enriquewph/Tablero-de-Crossfit/573515-030219 - copia.jpg

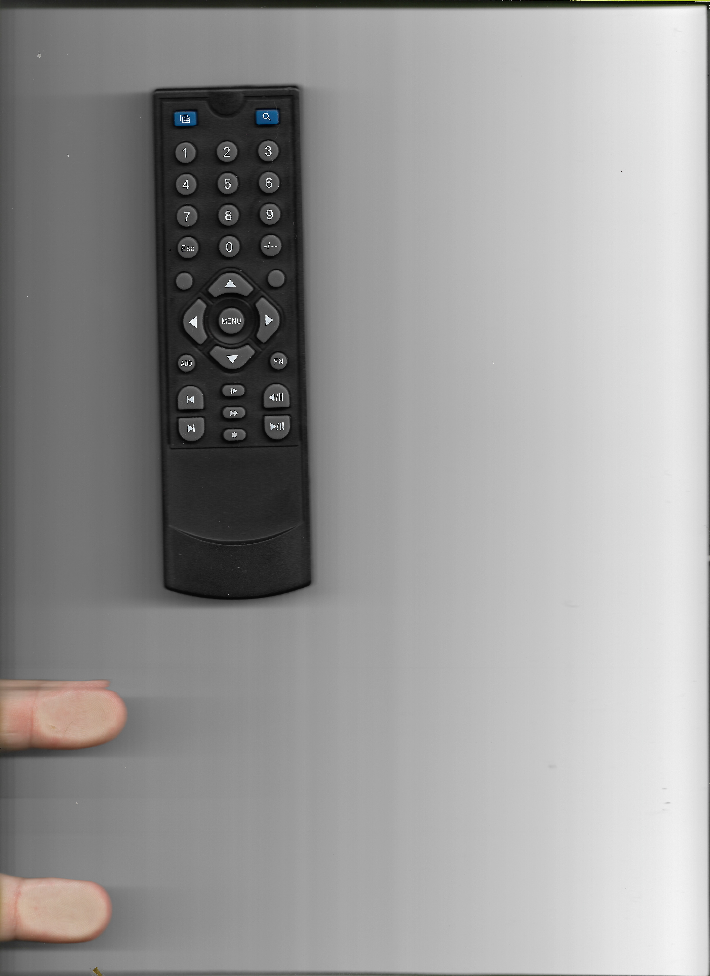
573515-030219 - copia.jpg
