enriquewph/Tablero-de-Crossfit/1.pdf

Componente | Cantidad | Precio | Subtotal
CABLE X METRO 1mm2 NEGRO | 5 | 3,00 $ | 15,00 $
CABLE X METRO 1mm2 ROJO | 2 | 3,00 $ | 6,00 $
CAPACITOR CERÁMICO 100nF | 8 | 2,00 $ | 16,00 $
CAPACITOR CERÁMICO 22pF | 2 | 2,00 $ | 4,00 $
CAPACITOR ELECTROLÍTICO 100uF 16v | 2 | 3,00 $ | 6,00 $
CAPACITOR ELECTROLÍTICO 10uF 16v | 1 | 3,00 $ | 3,00 $
CIRC. INTEGRADO 74HC595 | 6 | 15,00 $ | 90,00 $
CIRC. INTEGRADO ATMEGA328P-PU | 1 | 100,00 $ | 100,00 $
CIRC. INTEGRADO REG. LM7805 | 1 | 10,00 $ | 10,00 $
CONECTOR POLARIZADO 2.54mm 2 PINES Hembra p/Cable | 2 | 2,00 $ | 4,00 $
CONECTOR POLARIZADO 2.54mm 2 PINES Macho p/Placa | 2 | 2,00 $ | 4,00 $
CONECTOR POLARIZADO 2.54mm 3 PINES Hembra p/Cable | 1 | 3,00 $ | 3,00 $
CONECTOR POLARIZADO 2.54mm 3 PINES Macho p/Placa | 1 | 3,00 $ | 3,00 $
CONECTOR POLARIZADO 2.54mm 4 PINES Hembra p/Cable | 3 | 4,00 $ | 12,00 $
CONECTOR POLARIZADO 2.54mm 4 PINES Macho p/Placa | 3 | 4,00 $ | 12,00 $
CONECTOR POLARIZADO 2.54mm 5 PINES Hembra p/Cable | 2 | 4,00 $ | 8,00 $
CONECTOR POLARIZADO 2.54mm 5 PINES Macho p/Placa | 2 | 4,00 $ | 8,00 $
FUENTE CONMUTADA 12V 3A | 1 | 285,00 $ | 285,00 $
LED ROJO 5MM | 596 | 1,30 $ | 773,61 $
OSCILADOR CRISTAL 16MHz | 1 | 3,00 $ | 3,00 $
PINES HEMBRA 2.54MM (TIRA 40) | 2 | 15,00 $ | 30,00 $
PINES MACHO 2.54MM (TIRA 40) | 2 | 10,00 $ | 20,00 $
PINES P/CONECTORES POLARIZADOS (TIRAS DE 50) | 100 | 1,00 $ | 100,00 $
PLACA VIRGEN SIMPLE FAZ 25x25cm | 3 | 40,00 $ | 120,00 $
PLUG DC HEMBRA 2.1mm PARA PANEL | 1 | 10,00 $ | 10,00 $
RESISTENCIA 100 Ohm | 42 | 1,00 $ | 42,00 $
RESISTENCIA 10K Ohm | 44 | 1,00 $ | 44,00 $
RESISTENCIA 200 Ohm | 84 | 2,00 $ | 168,00 $
RESISTENCIA 470 Ohm | 1 | 1,00 $ | 1,00 $
TRANSISTOR BC547 TO92 | 43 | 6,00 $ | 258,00 $
TRANSISTOR TIP120 TO220 | 1 | 10,00 $ | 10,00 $
ZÓCALO DIP16 | 6 | 4,00 $ | 24,00 $
ZÓCALO DIP28 | 1 | 9,00 $ | 9,00 $
CONTROL REMOTO IR | 1 | 40,00 $ | 40,00 $
BATERIA CR20321 | 1 | 40,00 $ | 40,00 $
RECEPTOR IR STOP21332 | 1 | 40,00 $ | 40,00 $
SENSOR TEMP Y HUMEDAD DHT11 | 1 | 50,00 $ | 50,00 $
RESISTENCIA SMD 10K | 1 | 0,25 $ | 0,25 $
PLACA DRIVER 74HC595 | 6 | 30,00 $ | 180,00 $
SUBTOTAL: | 2.551,858 $

# COMPONENTES ELECTRÓNICOS
