enriquewph/Tablero-de-Crossfit/2.pdf

ITEM | CANTIDAD | PRECIO | SUBTOTAL
Separador 5mm | 8 | $ | 2,00 $ | 16,00
Separador 9mm | 52 | $ | 3,00 $ | 156,00
Tornillo M3x10 ALLEN C. CILINDRICA | 4 | $ | 2,38 $ | 9,52
Tornillo M3x10 ALLEN C. FRESADA | 76 | $ | 3,56 $ | 270,56
Tornillo M3x20 ALLEN C. FRESADA | 60 | $ | 3,37 $ | 202,20
Tuerca M3 | 68 | $ | 0,56 $ | 38,08
SUBTOTAL | 692,36

# BULONERÍA
