enriquewph/Tablero-de-Crossfit/573515-030219.jpg

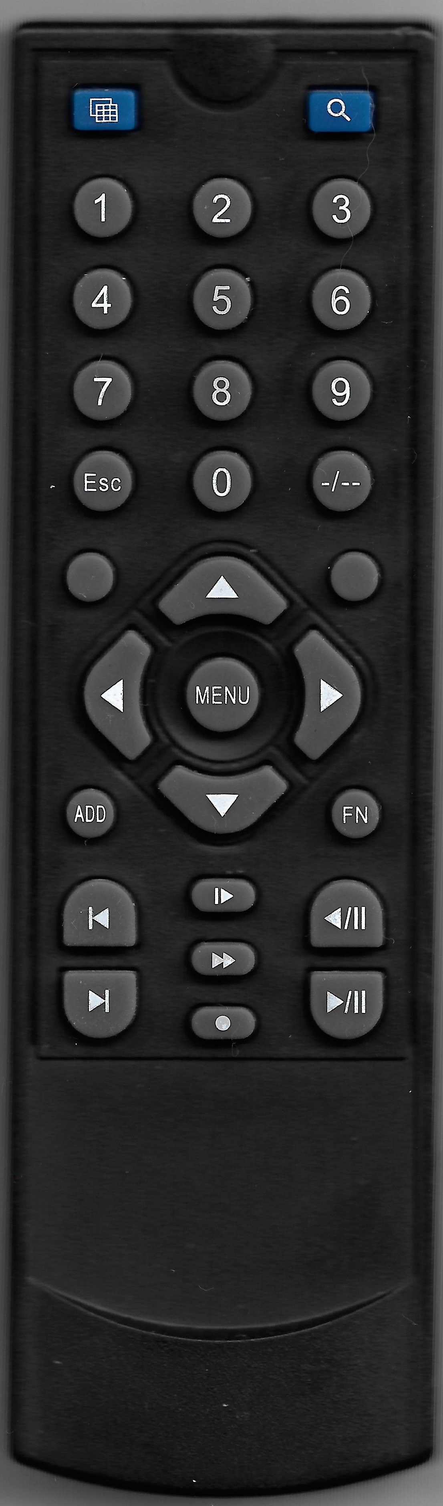
573515-030219.jpg
