enriquewph/Tablero-de-Crossfit/Cotizacion Electrocomponentes.xlsx

Componente | Cantidad | Precio | Subtotal
CAPACITOR ELECTROLÍTICO 100uF 16v | 2 |  | $0.000
CAPACITOR ELECTROLÍTICO 10uF 16v | 1 |  | $0.000
CONECTOR POLARIZADO 2.54mm 2 PINES Hembra p/Cable | 2 |  | $0.000
CONECTOR POLARIZADO 2.54mm 2 PINES Macho p/Placa | 2 |  | $0.000
CONECTOR POLARIZADO 2.54mm 3 PINES Hembra p/Cable | 2 |  | $0.000
CONECTOR POLARIZADO 2.54mm 3 PINES Macho p/Placa | 2 |  | $0.000
CONECTOR POLARIZADO 2.54mm 4 PINES Hembra p/Cable | 1 |  | $0.000
CONECTOR POLARIZADO 2.54mm 4 PINES Macho p/Placa | 1 |  | $0.000
CONECTOR POLARIZADO 2.54mm 5 PINES Hembra p/Cable | 2 |  | $0.000
CONECTOR POLARIZADO 2.54mm 5 PINES Macho p/Placa | 2 |  | $0.000
PINES HEMBRA 2.54MM (TIRA 40) | 2 |  | $0.000
PINES MACHO 2.54MM (TIRA 40) | 2 |  | $0.000
PINES P/CONECTORES POLARIZADOS (TIRAS DE 50) | 100 |  | $0.000
RESISTENCIA 100 Ohm | 42 |  | $0.000
RESISTENCIA 200 Ohm | 84 |  | $0.000
TRANSISTOR BC547 TO92 | 43 |  | $0.000
TRANSISTOR TIP120 TO220 | 1 |  | $0.000
