enriquewph/Tablero-de-Crossfit/CAD/3D MCAD MODELS/MAINBOARD/Mainboard.STEP

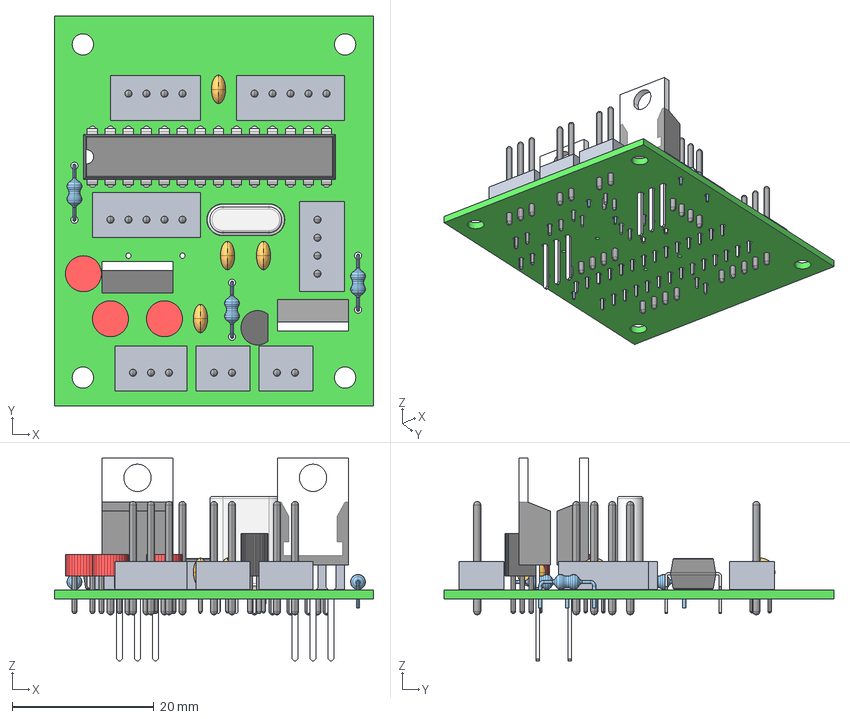
[picture p3: CAD file, 2019-03-29]
CAD/3D MCAD MODELS/MAINBOARD/Mainboard.STEP
45.0 x 55.0 x 28.6 mm
Layer_1
Pin_1 x 15
Pin_2 x 15
Pin_3 x 6
Pin_4 x 4
Pin_5 x 2
=>[0:1:1:3] x 3
=>[0:1:1:4] x 3
=>[0:1:1:5] x 3
