enriquewph/Tablero-de-Crossfit/CAD/Piezas Varias/Ajuste Display.SLDASM

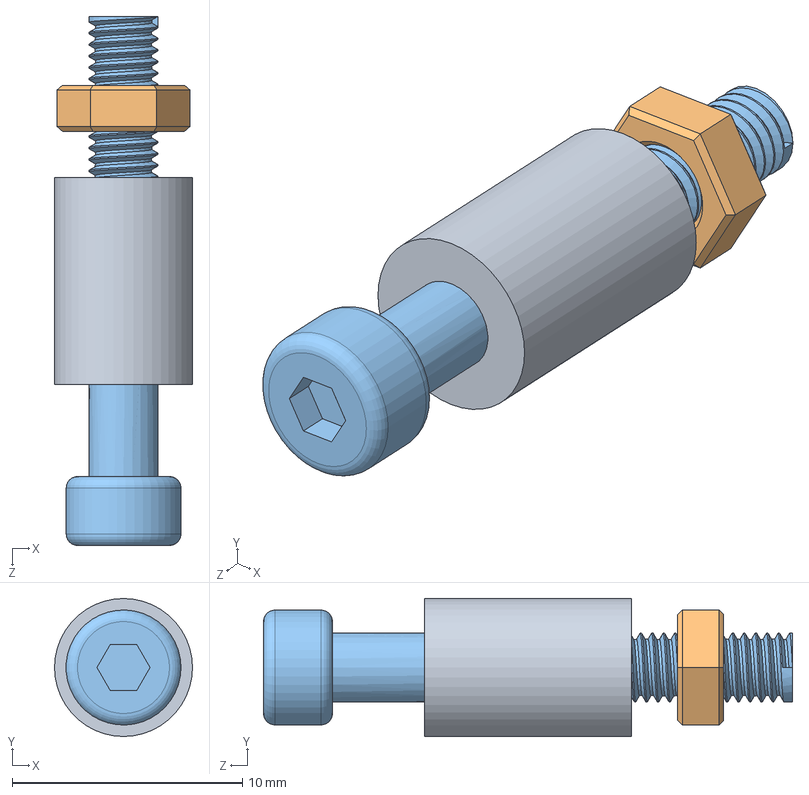
[picture p4: CAD file, 2019-03-29]
CAD/Piezas Varias/Ajuste Display.SLDASM
6.00 x 6.00 x 23.0 mm
Separador
Tuerca M3
Tornillo M3x20_CC
