enriquewph/Tablero-de-Crossfit/CAD/placasviejas/Placa Main.SLDPRT

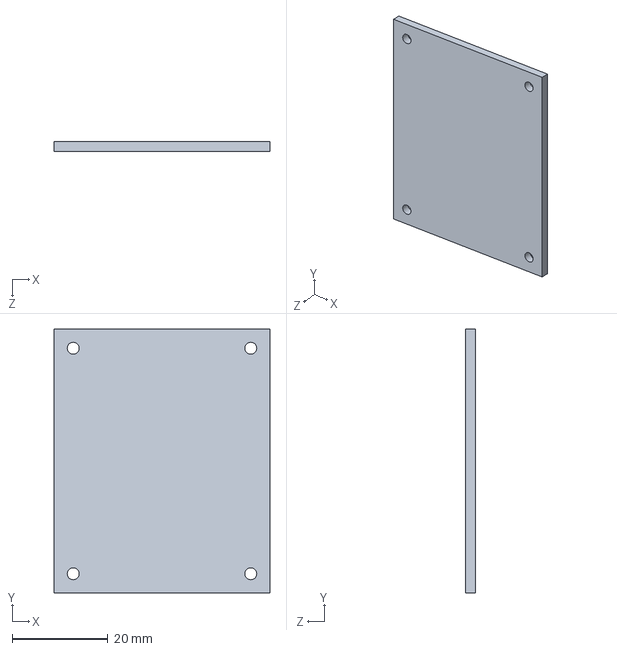
[picture p5: CAD file, 2019-03-29]
CAD/placasviejas/Placa Main.SLDPRT
45.0 x 55.0 x 2.00 mm
