enriquewph/Tablero-de-Crossfit/CAD/placasviejas/PLACAIRDHT.SLDASM

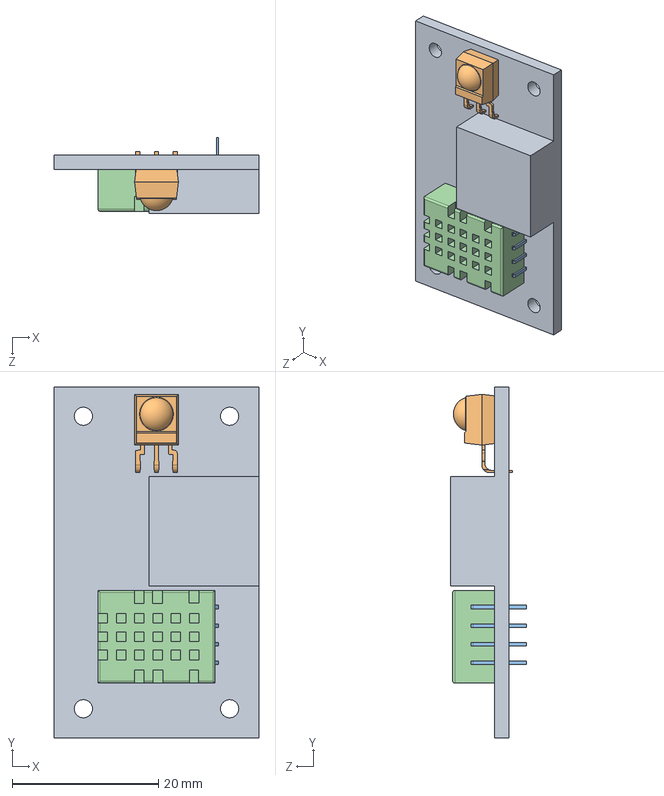
[picture p6: CAD file, 2019-03-29]
CAD/placasviejas/PLACAIRDHT.SLDASM
28.0 x 48.0 x 10.4 mm
PCB
IRREC
