enriquewph/Tablero-de-Crossfit/Proteus/DHT+IR/PLACAFULL.SLDASM

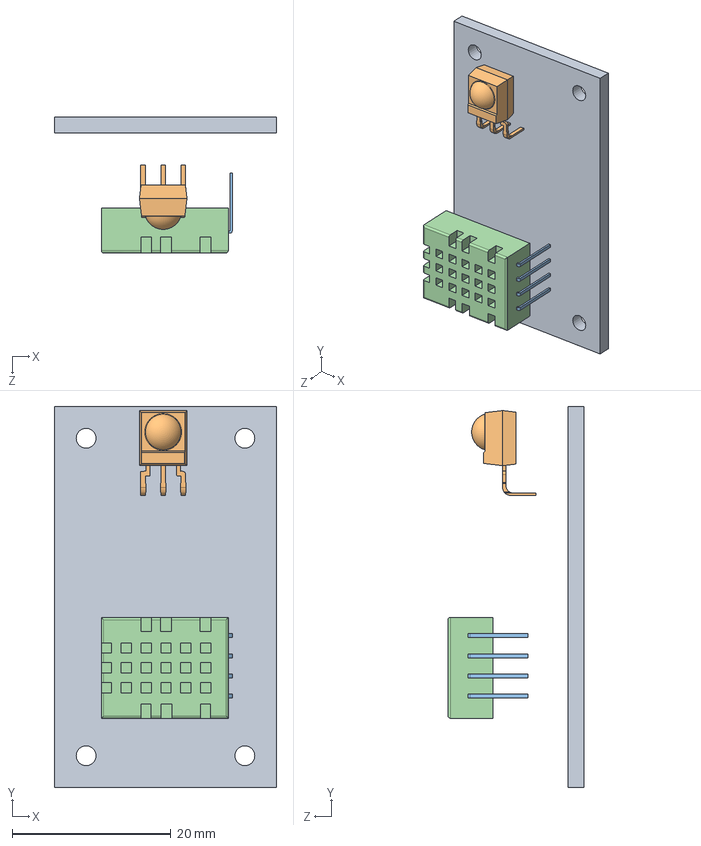
[picture p7: CAD file, 2019-03-29]
Proteus/DHT+IR/PLACAFULL.SLDASM
28.0 x 48.0 x 17.2 mm
PCB
IRREC
