enriquewph/Tablero-de-Crossfit/CAD/Cantos.SLDASM

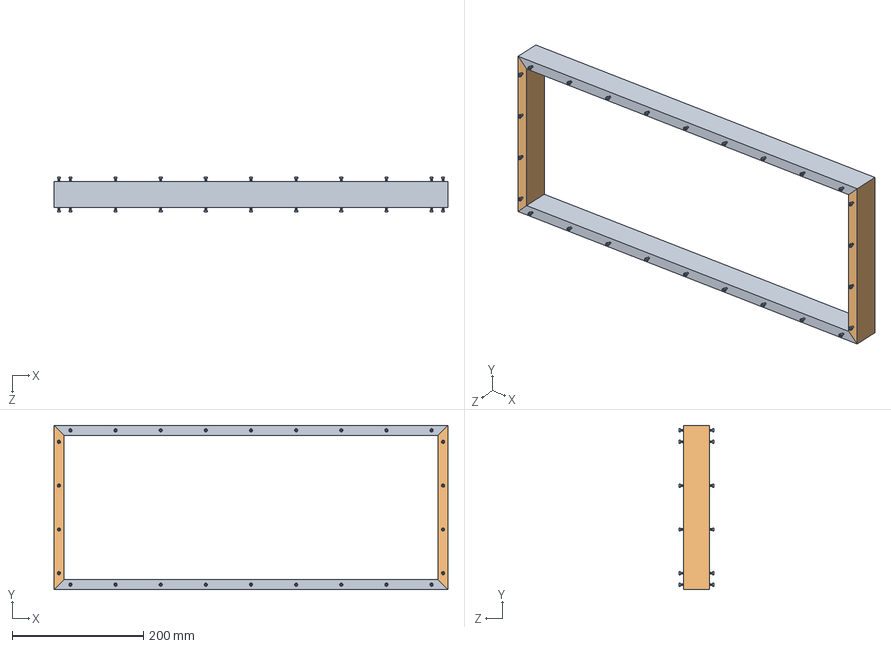
[picture p8: CAD file, 2019-03-29]
CAD/Cantos.SLDASM
600.0 x 250.0 x 54.0 mm
Canto_Largo_madera x 2
Canto_Corto_madera x 2
Tornillo M3x10_CC x 52
