enriquewph/Tablero-de-Crossfit/CAD/Ensamblaje.SLDASM

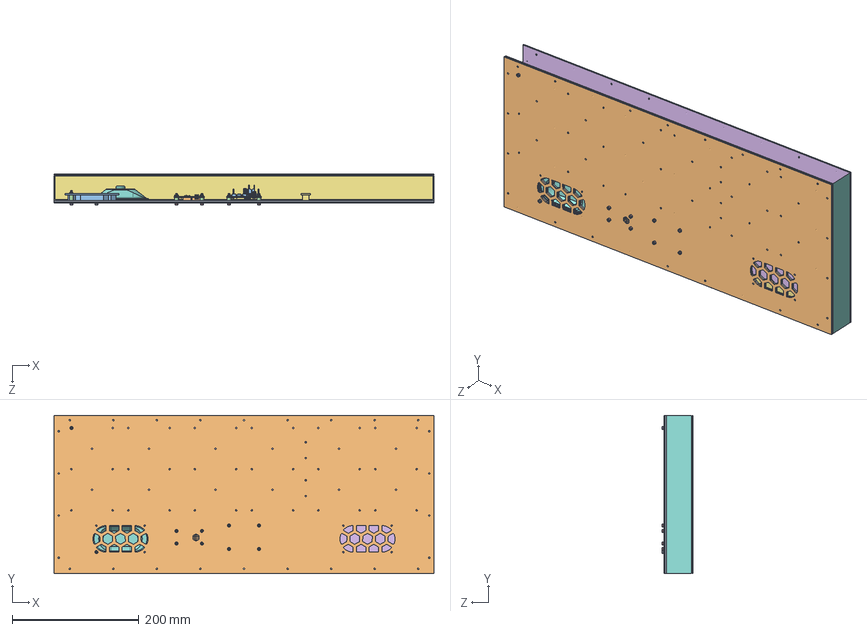
[picture p9: CAD file, 2019-03-29]
CAD/Ensamblaje.SLDASM
600.0 x 250.0 x 49.0 mm
Acrilico Frontal_back
Acrilico Frontal_front
dht+ir
Mainboard
Separador 5mm x 8
Tuerca M3 x 8
Tornillo M3x15_CC x 8
