enriquewph/Tablero-de-Crossfit/CAD/Piezas Varias/Ajuste Placas.SLDASM

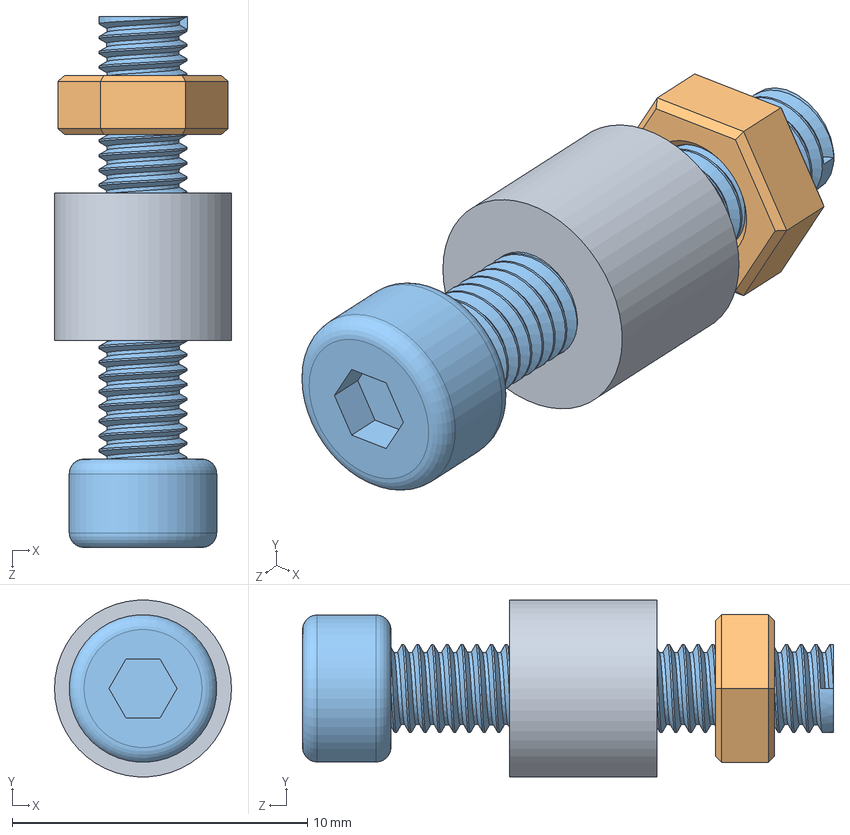
[picture p10: CAD file, 2019-03-29]
CAD/Piezas Varias/Ajuste Placas.SLDASM
6.00 x 5.99 x 18.0 mm
Separador 5mm
Tuerca M3
Tornillo M3x15_CC
