enriquewph/Tablero-de-Crossfit/Proteus/DHT+IR/DHT11.SLDASM

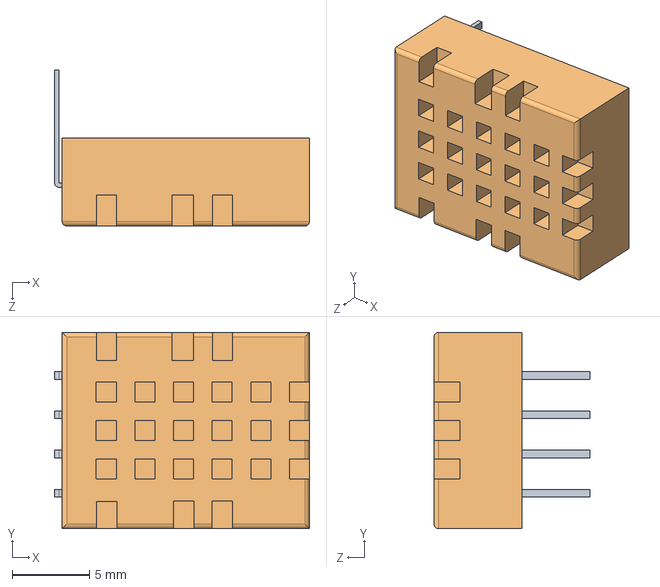
[picture p11: CAD file, 2019-03-29]
Proteus/DHT+IR/DHT11.SLDASM
16.5 x 12.7 x 10.1 mm
