enriquewph/Tablero-de-Crossfit/CAD/Perfiles.SLDASM

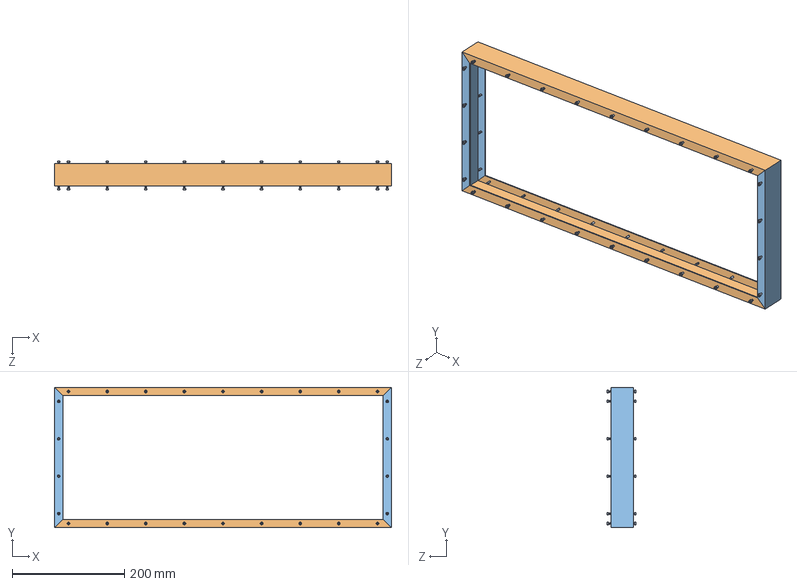
[picture p12: CAD file, 2019-03-29]
CAD/Perfiles.SLDASM
600.0 x 250.0 x 52.0 mm
Tornillo M3x10_CC x 52
Perfil_Largo_alum x 2
Perfil_Corto_alum x 2
