enriquewph/Tablero-de-Crossfit/CAD/Dospuntos.SLDASM

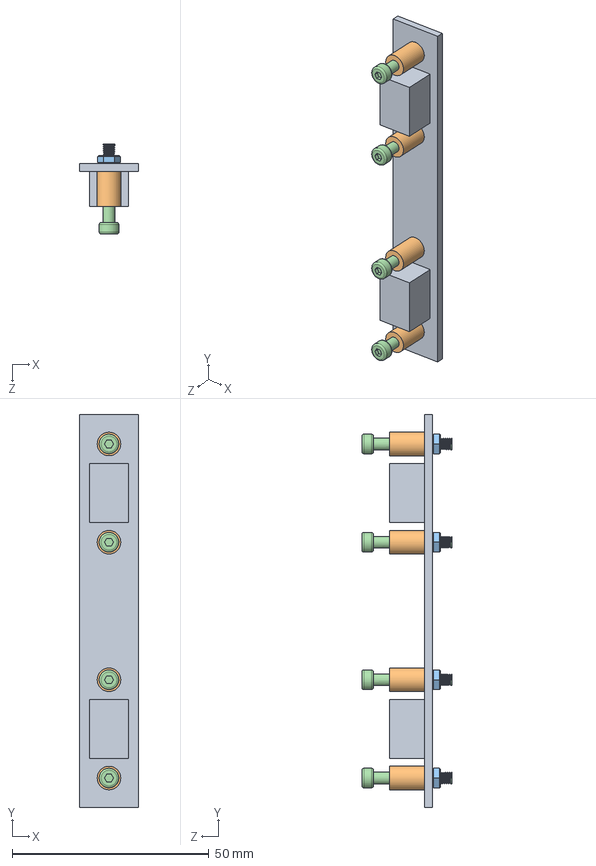
[picture p13: CAD file, 2019-03-29]
CAD/Dospuntos.SLDASM
15.0 x 100.0 x 23.0 mm
PlacaDospuntos
Separador x 4
Tuerca M3 x 4
Tornillo M3x20_CC x 4
