enriquewph/Tablero-de-Crossfit/CAD/Parl.SLDASM

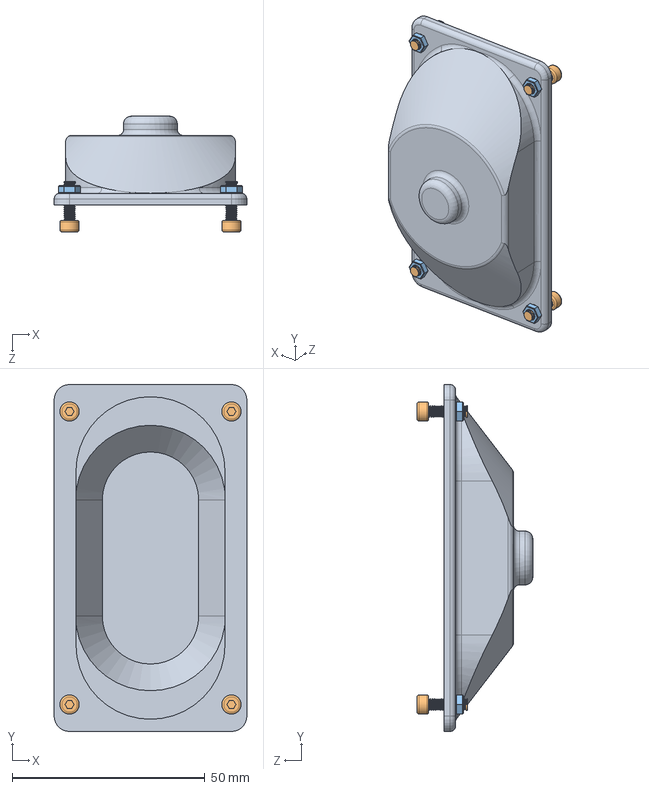
[picture p14: CAD file, 2019-03-29]
CAD/Parl.SLDASM
50.0 x 90.0 x 30.0 mm
Parlante
Tornillo M3x10_CC x 4
Tuerca M3 x 4
