enriquewph/Tablero-de-Crossfit/CAD/Display.SLDASM

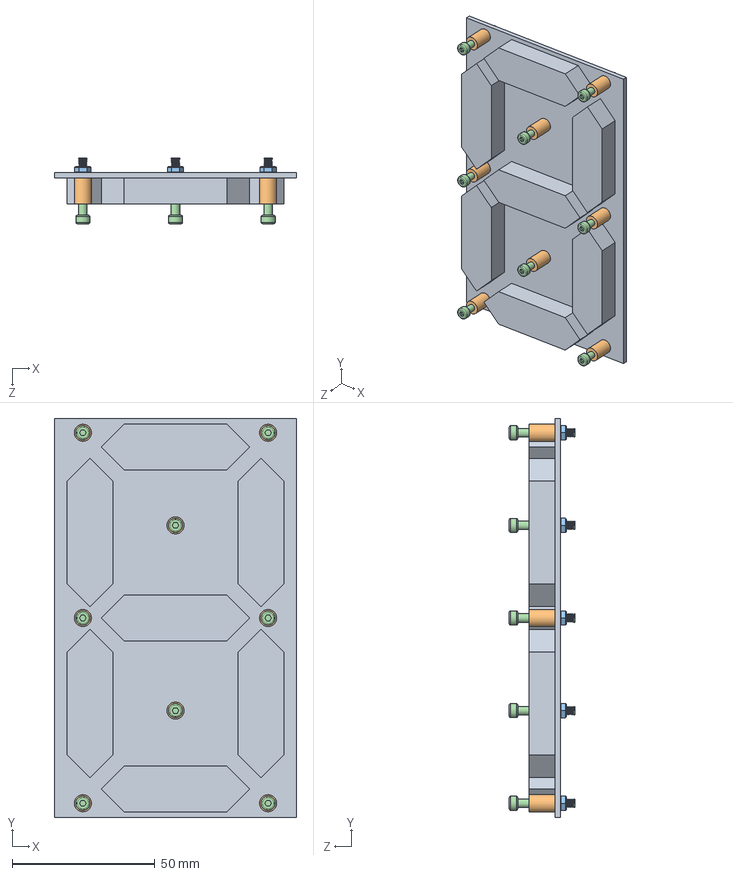
[picture p15: CAD file, 2019-03-29]
CAD/Display.SLDASM
85.0 x 140.0 x 23.0 mm
Display
Separador x 8
Tuerca M3 x 8
Tornillo M3x20_CC x 8
