enriquewph/Tablero-de-Crossfit/CAD/3D MCAD MODELS/DHT+IR/dht+ir.STEP

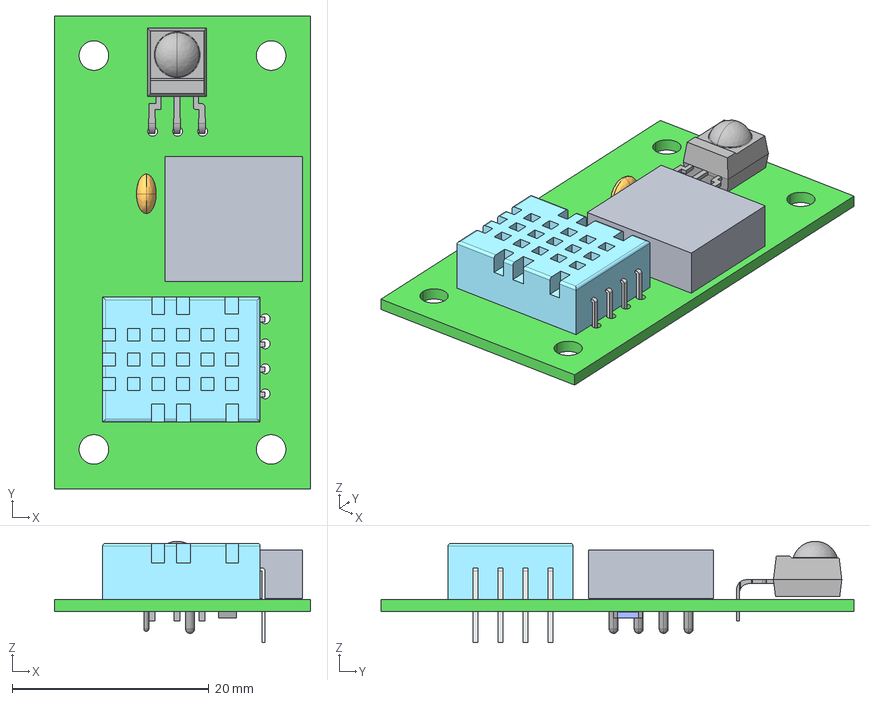
[picture p16: CAD file, 2019-03-29]
CAD/3D MCAD MODELS/DHT+IR/dht+ir.STEP
26.0 x 48.0 x 10.3 mm
Layer_1
=>[0:1:1:4]
=>[0:1:1:5]
=>[0:1:1:6]
=>[0:1:1:7]
Pin_1 x 3
Pin_2 x 3
Pin_3
Pin_4
