enriquewph/Tablero-de-Crossfit/CAD/3D MCAD MODELS/DISPLAY7SEG/Display7seg20x10.STEP

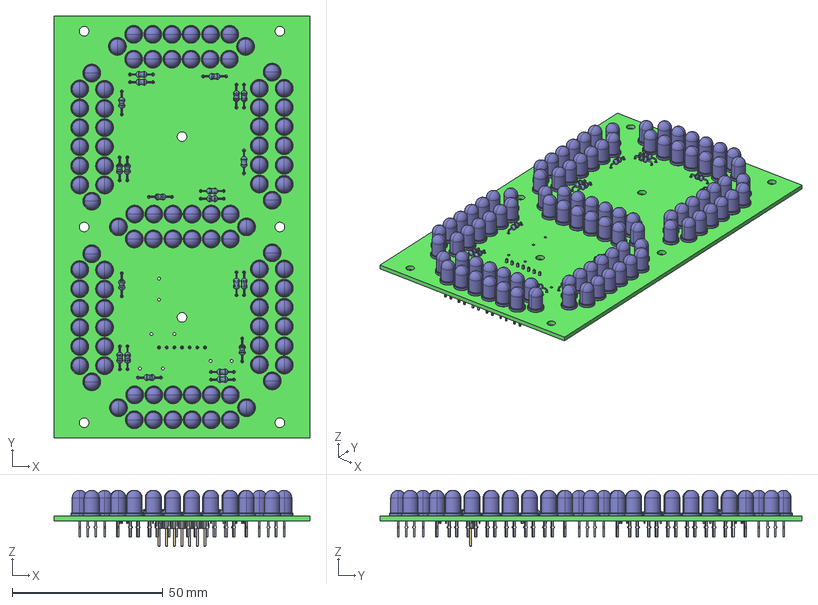
[picture p17: CAD file, 2019-03-29]
CAD/3D MCAD MODELS/DISPLAY7SEG/Display7seg20x10.STEP
85.0 x 140.0 x 18.8 mm
Layer_1
=>[0:1:1:3] x 22
=>[0:1:1:4] x 22
=>[0:1:1:5] x 22
=>[0:1:1:6]
=>[0:1:1:7]
=>[0:1:1:8]
=>[0:1:1:9]
=>[0:1:1:10]
