enriquewph/Tablero-de-Crossfit/CAD/3D MCAD MODELS/INDICADORSEGUNDOS/IndicadorSegundos.STEP

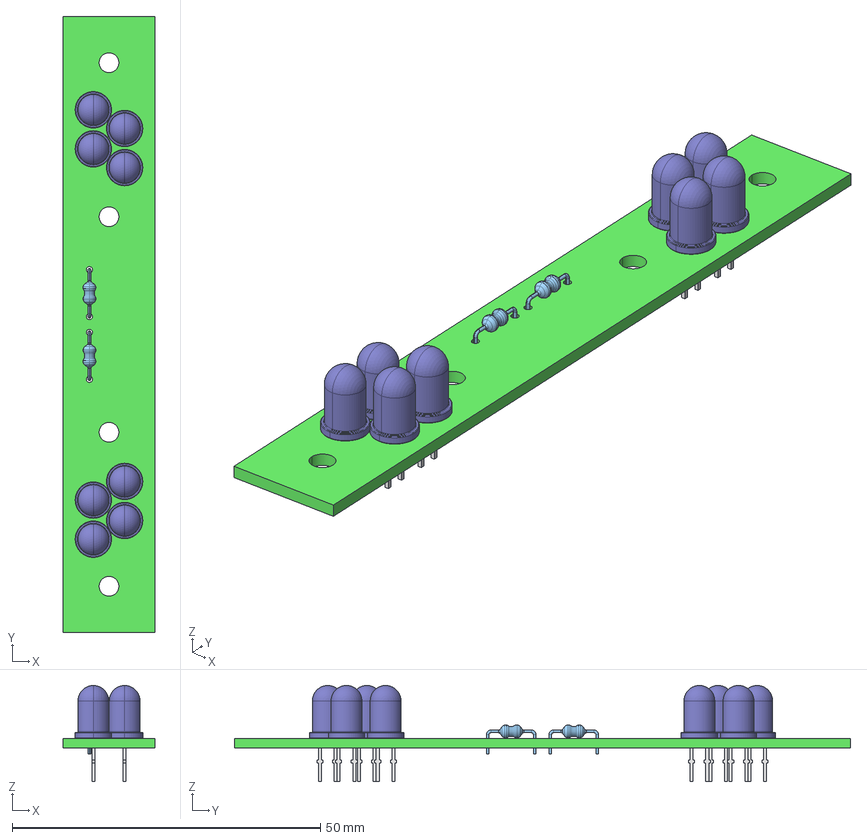
[picture p18: CAD file, 2019-03-29]
CAD/3D MCAD MODELS/INDICADORSEGUNDOS/IndicadorSegundos.STEP
15.0 x 100.0 x 15.6 mm
Layer_1
=>[0:1:1:3] x 2
=>[0:1:1:4] x 2
=>[0:1:1:5] x 2
