enriquewph/Tablero-de-Crossfit/CAD/Perfil_Largo_alum.SLDPRT

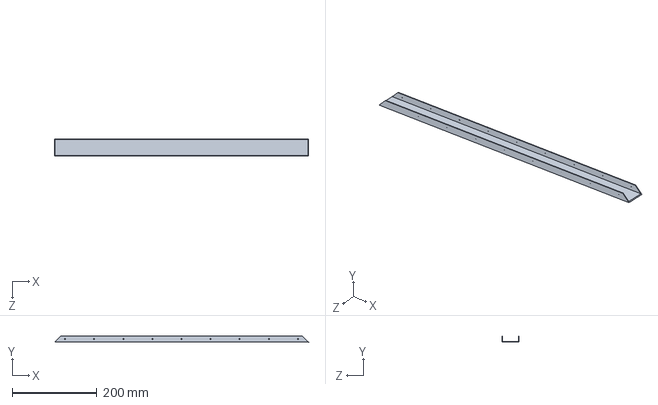
[picture p19: CAD file, 2019-03-29]
CAD/Perfil_Largo_alum.SLDPRT
600.0 x 15.0 x 40.0 mm
