enriquewph/Tablero-de-Crossfit/Proteus/DHT+IR/PCB.SLDPRT

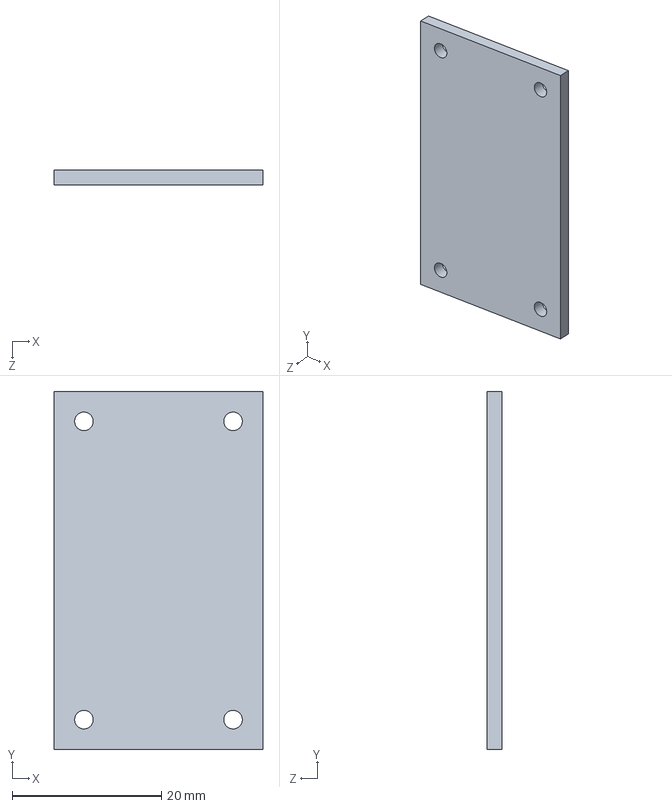
[picture p20: CAD file, 2019-03-29]
Proteus/DHT+IR/PCB.SLDPRT
28.0 x 48.0 x 2.00 mm
