enriquewph/Tablero-de-Crossfit/Proteus/Display 7 segmentos 20x10/Display7seg20x10.STEP

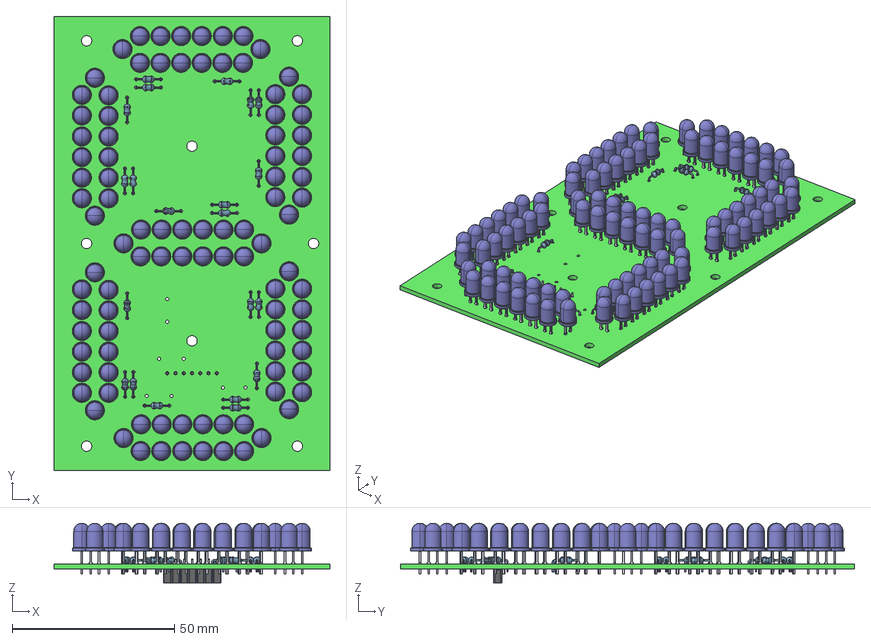
[picture p21: CAD file, 2019-03-29]
Proteus/Display 7 segmentos 20x10/Display7seg20x10.STEP
85.0 x 140.0 x 18.4 mm
Layer_1
=>[0:1:1:3] x 21
=>[0:1:1:4] x 21
=>[0:1:1:5] x 21
