enriquewph/Tablero-de-Crossfit/CAD/Parlante.SLDPRT

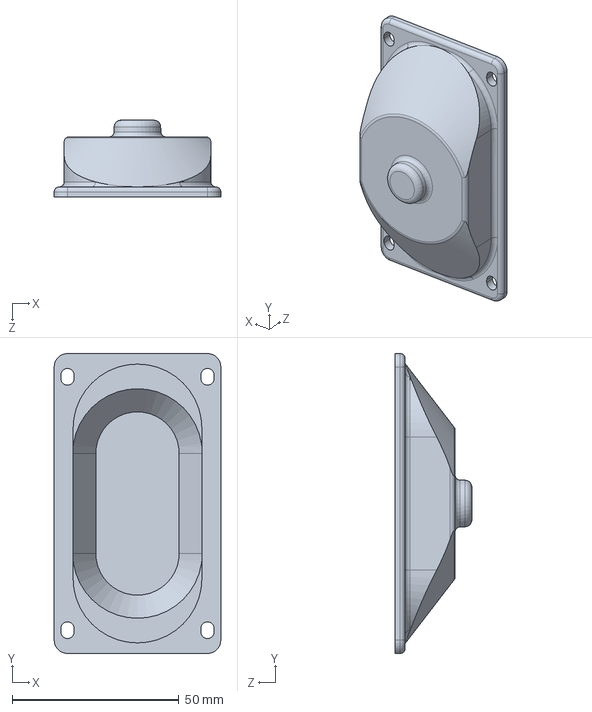
[picture p22: CAD file, 2019-03-29]
CAD/Parlante.SLDPRT
50.0 x 90.0 x 23.0 mm
