enriquewph/Tablero-de-Crossfit/CAD/Piezas Varias/Tornillo M3x15_CC.SLDPRT

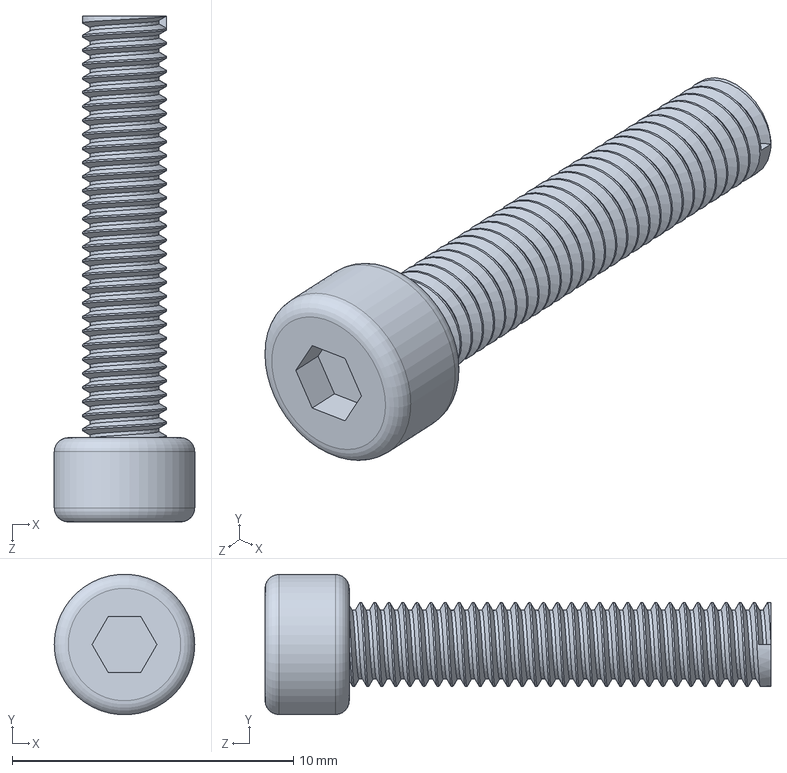
[picture p23: CAD file, 2019-03-29]
CAD/Piezas Varias/Tornillo M3x15_CC.SLDPRT
5.00 x 4.99 x 18.0 mm
