enriquewph/Tablero-de-Crossfit/CAD/placasviejas/PlacaDospuntos.SLDPRT

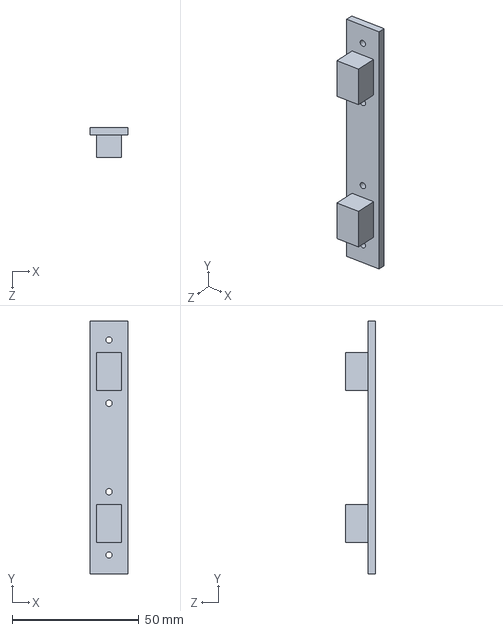
[picture p24: CAD file, 2019-03-29]
CAD/placasviejas/PlacaDospuntos.SLDPRT
15.0 x 100.0 x 12.0 mm
