enriquewph/Tablero-de-Crossfit/CAD/Chapa Soporte.SLDPRT

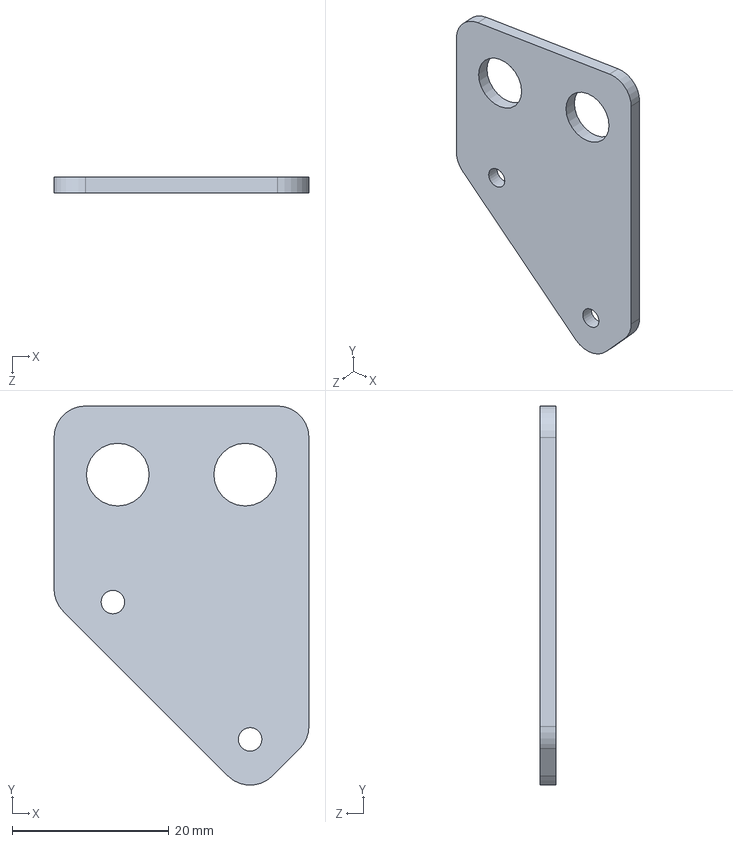
[picture p25: CAD file, 2019-03-29]
CAD/Chapa Soporte.SLDPRT
32.5 x 48.3 x 2.00 mm
