enriquewph/Tablero-de-Crossfit/CAD/Piezas Varias/Tornillo M3x20_CC.SLDPRT

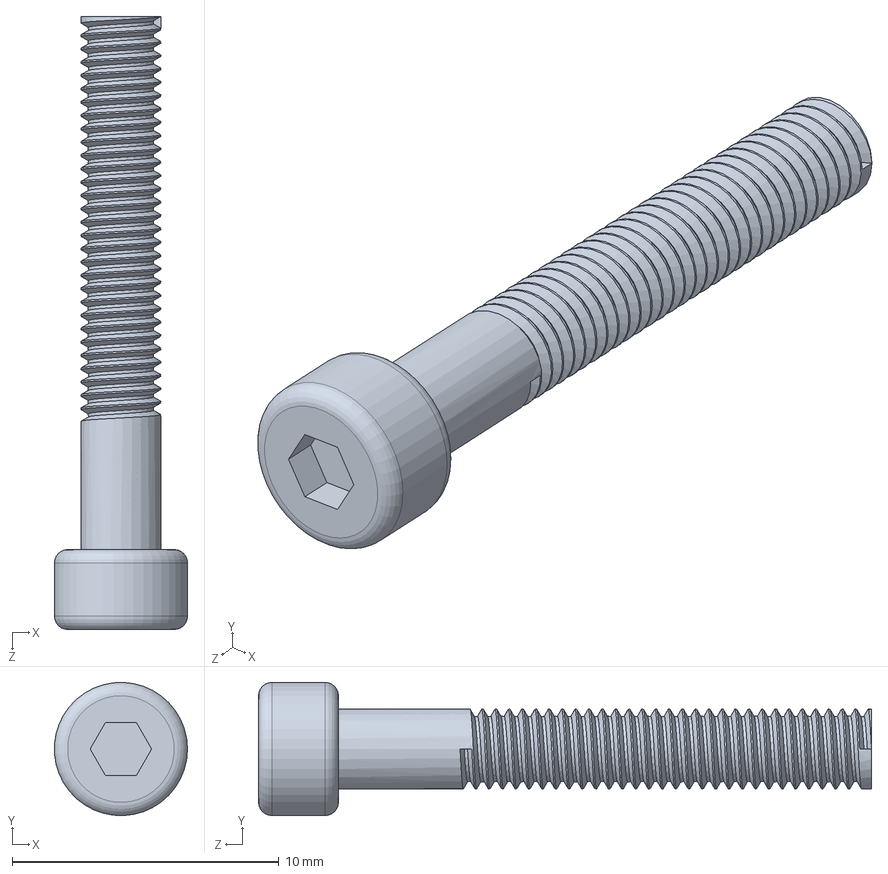
[picture p26: CAD file, 2019-03-29]
CAD/Piezas Varias/Tornillo M3x20_CC.SLDPRT
4.99 x 5.00 x 23.0 mm
