enriquewph/Tablero-de-Crossfit/CAD/Piezas Varias/Separador 9mm.STL

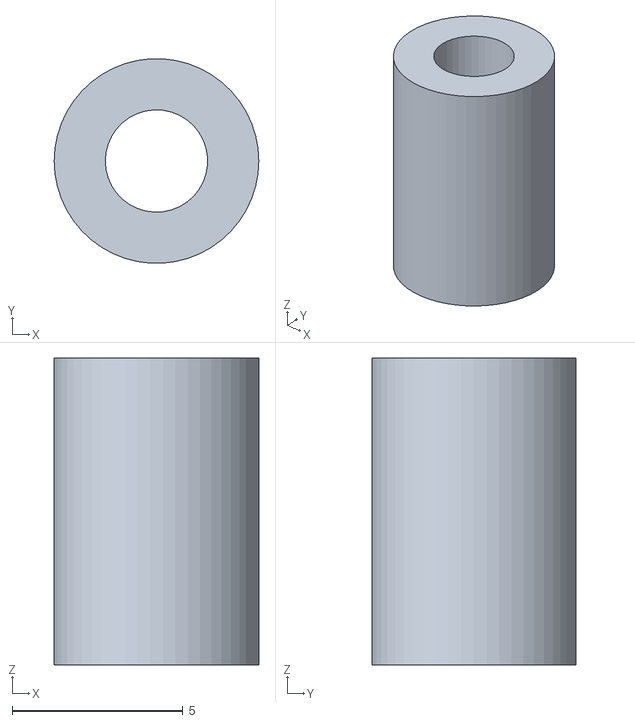
[picture p27: CAD file, 2019-03-29]
CAD/Piezas Varias/Separador 9mm.STL
6.00 x 5.99 x 9.00
