enriquewph/Tablero-de-Crossfit/CAD/placasviejas/Display.SLDPRT

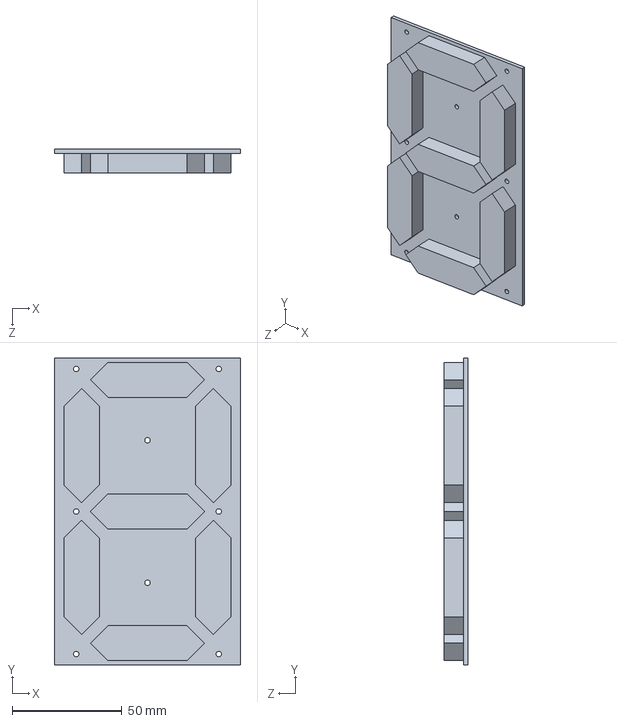
[picture p28: CAD file, 2019-03-29]
CAD/placasviejas/Display.SLDPRT
85.0 x 140.0 x 11.0 mm
