enriquewph/Tablero-de-Crossfit/CAD/Acrilico Frontal_back.SLDPRT

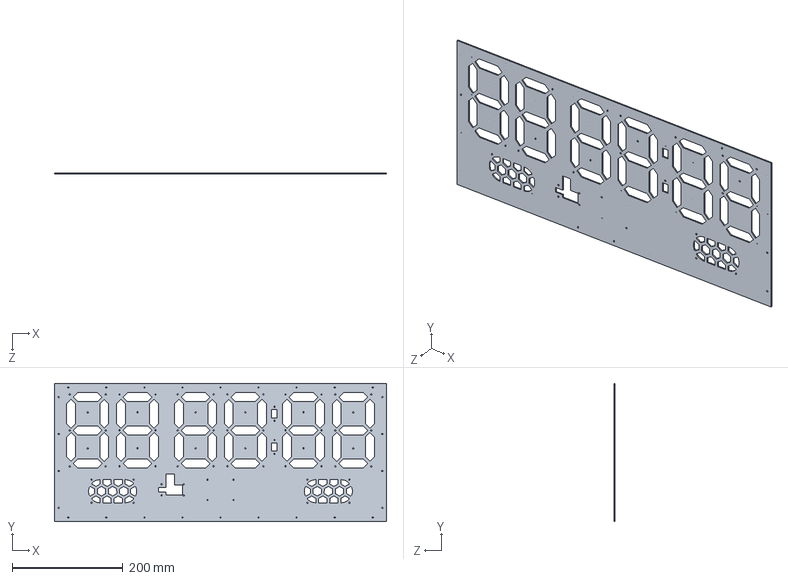
[picture p29: CAD file, 2019-03-29]
CAD/Acrilico Frontal_back.SLDPRT
600.0 x 250.0 x 2.00 mm
