enriquewph/Tablero-de-Crossfit/CAD/Piezas Varias/Tuerca M3.SLDPRT

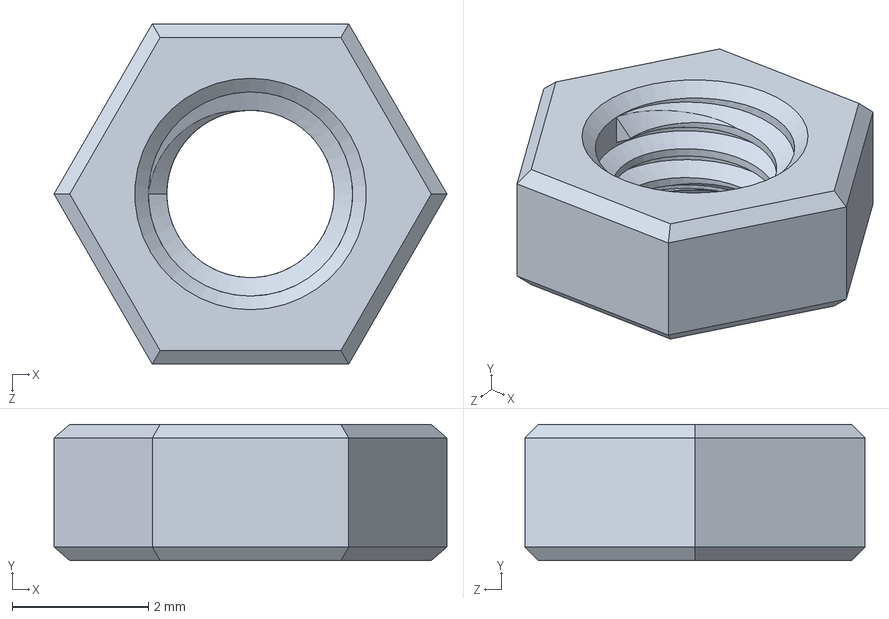
[picture p30: CAD file, 2019-03-29]
CAD/Piezas Varias/Tuerca M3.SLDPRT
5.77 x 2.00 x 5.00 mm
