enriquewph/Tablero-de-Crossfit/Proteus/DHT+IR/IRREC.SLDPRT

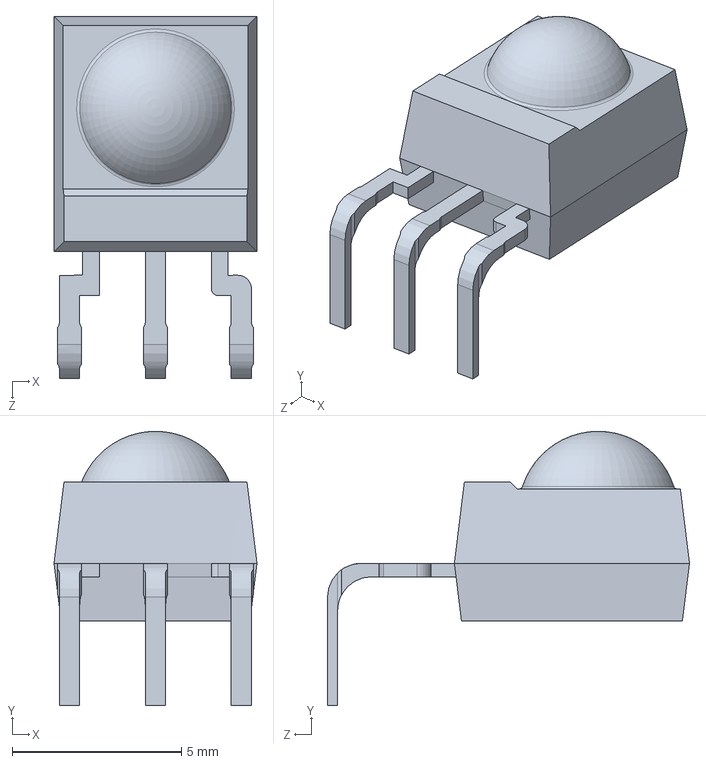
[picture p31: CAD file, 2019-03-29]
Proteus/DHT+IR/IRREC.SLDPRT
6.00 x 8.11 x 10.7 mm
