enriquewph/Tablero-de-Crossfit/CAD/Perfil_Corto_alum.SLDPRT

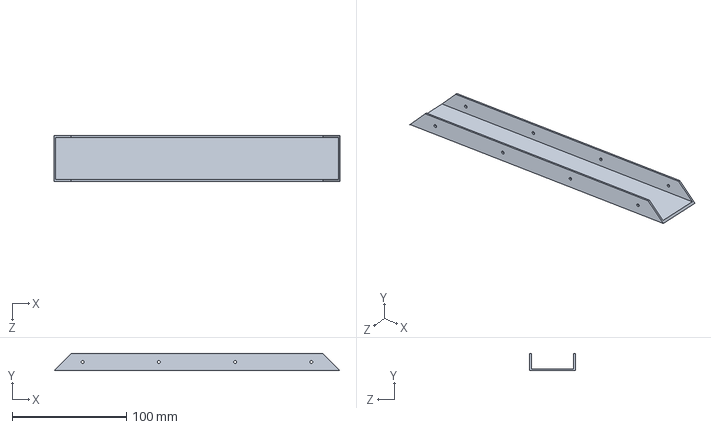
[picture p32: CAD file, 2019-03-29]
CAD/Perfil_Corto_alum.SLDPRT
250.0 x 15.0 x 40.0 mm
