enriquewph/Tablero-de-Crossfit/CAD/Piezas Varias/Separador 5mm.SLDPRT

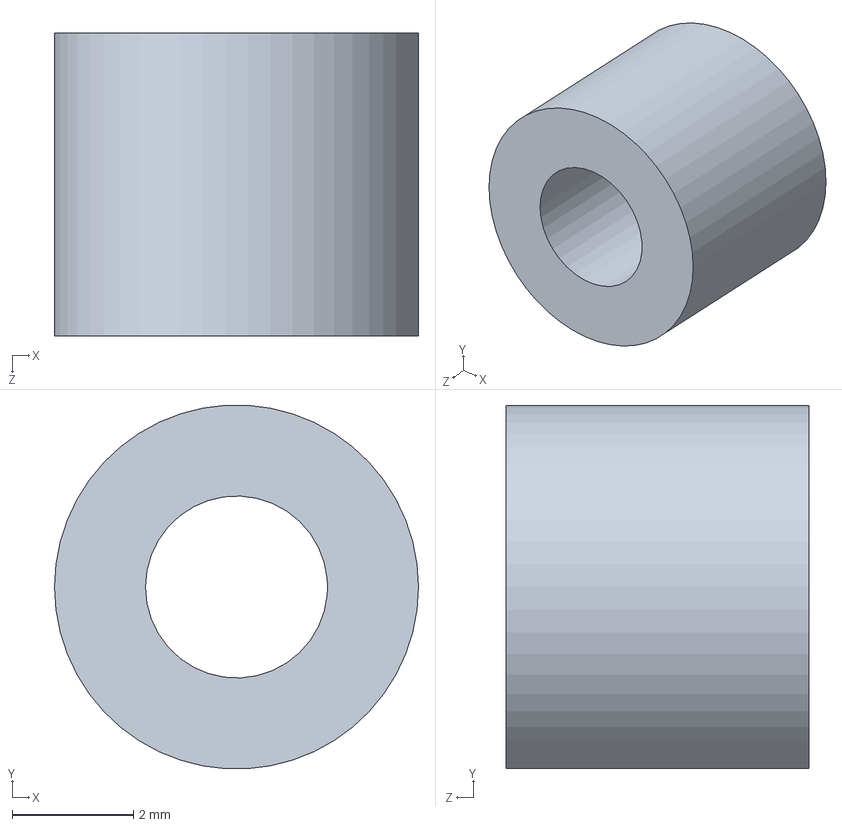
[picture p33: CAD file, 2019-03-29]
CAD/Piezas Varias/Separador 5mm.SLDPRT
6.00 x 5.99 x 5.00 mm
