enriquewph/Tablero-de-Crossfit/CAD/Canto_Largo_madera.SLDPRT

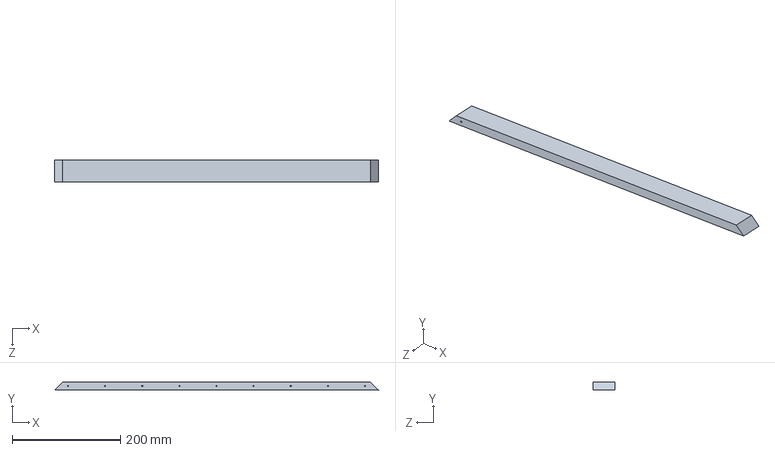
[picture p34: CAD file, 2019-03-29]
CAD/Canto_Largo_madera.SLDPRT
600.0 x 15.0 x 40.0 mm
