enriquewph/Tablero-de-Crossfit/CAD/Piezas Varias/Tornillo M3x10_CC.SLDPRT

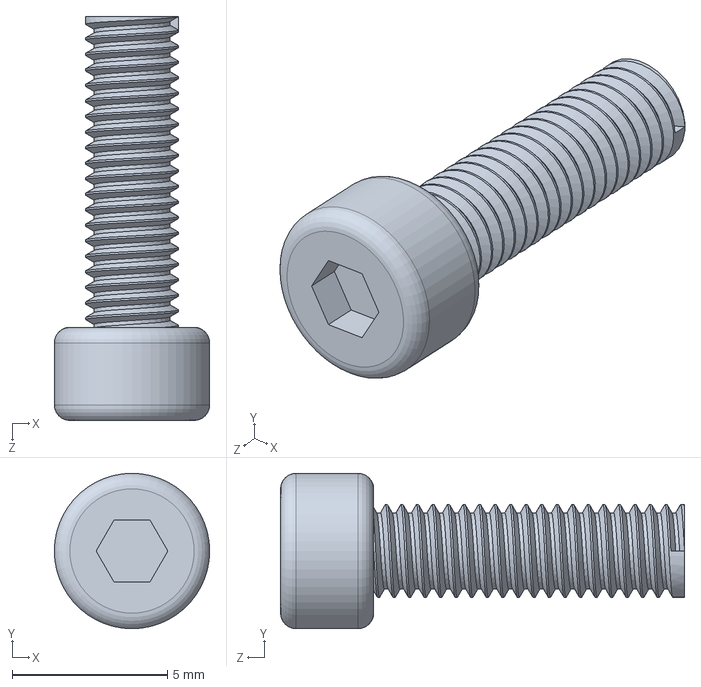
[picture p35: CAD file, 2019-03-29]
CAD/Piezas Varias/Tornillo M3x10_CC.SLDPRT
5.00 x 5.00 x 13.0 mm
