enriquewph/Tablero-de-Crossfit/CAD/Canto_Corto_madera.SLDPRT

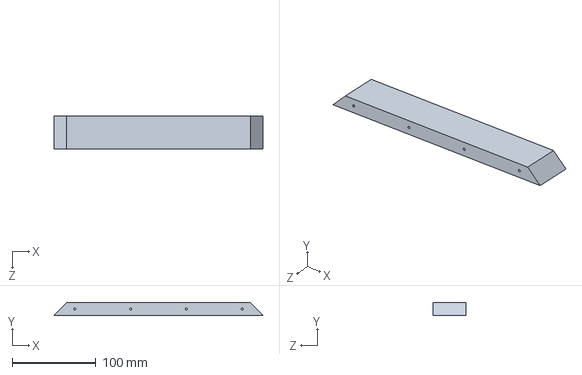
[picture p36: CAD file, 2019-03-29]
CAD/Canto_Corto_madera.SLDPRT
250.0 x 15.0 x 40.0 mm
