enriquewph/Tablero-de-Crossfit/CAD/Acrilico Frontal_front.SLDPRT

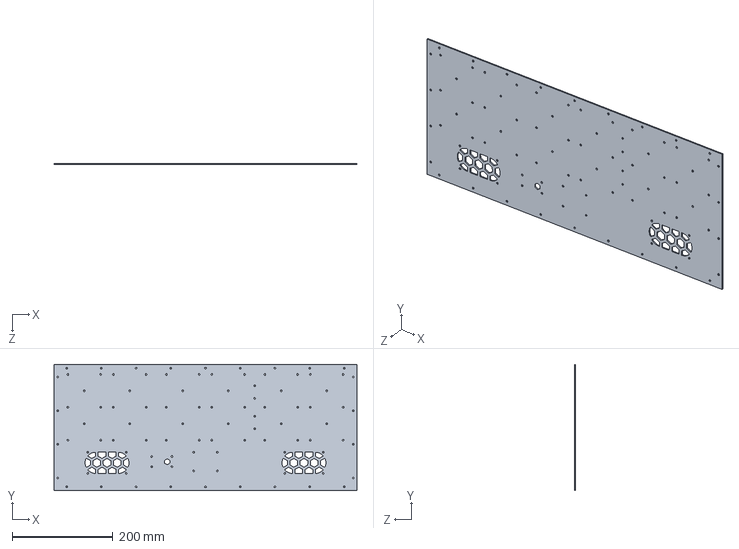
[picture p37: CAD file, 2019-03-29]
CAD/Acrilico Frontal_front.SLDPRT
600.0 x 250.0 x 2.00 mm
