enriquewph/Tablero-de-Crossfit/(list of files, cad)

Other CAD files:
Proteus/DHT+IR/Cut.sldprt
Proteus/DHT+IR/Array002.sldprt
CAD/Piezas Varias/Separador.SLDPRT
Proteus/DHT+IR/DHT11_H.step
CAD/Acrilico Trasero.SLDPRT
Acrilico Frontal_front.DWG
CAD/3D MCAD MODELS/DHT+IR/dht+ir.SLDPRT
CAD/3D MCAD MODELS/INDICADORSEGUNDOS/IndicadorSegundos.SLDPRT
CAD/3D MCAD MODELS/MAINBOARD/Mainboard.SLDPRT
CAD/Piezas Varias/Separador 5mm.STL
