enriquewph/Tablero-de-Crossfit/CORTES PCB.pdf

## ID-01000001 Code011 - Creator of the CutMaster 2D1 -Projects

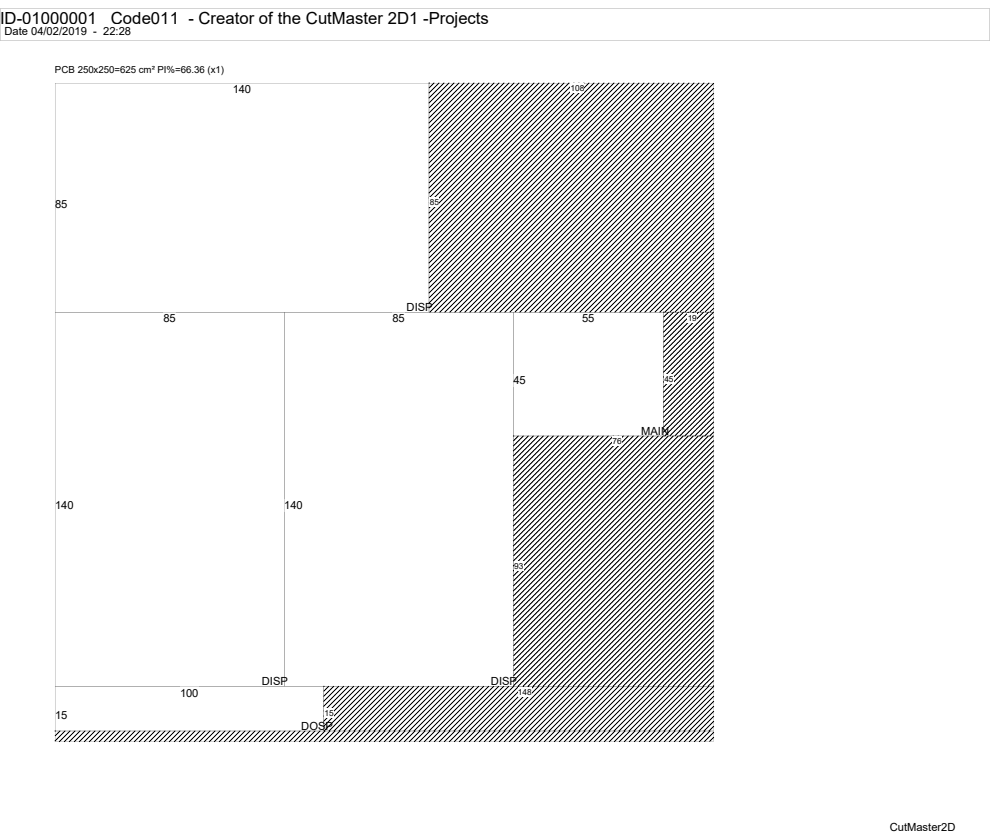
[picture p41: page 1]
DISP; DOSP; Date 04/02/2019 - 22:28; CutMaster2D

PCB 250x250=625 cm² PI%=66.36 (x1)

140 85 DISP | 108 85

55 45 MAIN | 19 45

## ID-01000001 Code011 - Creator of the CutMaster 2D2 -Projects

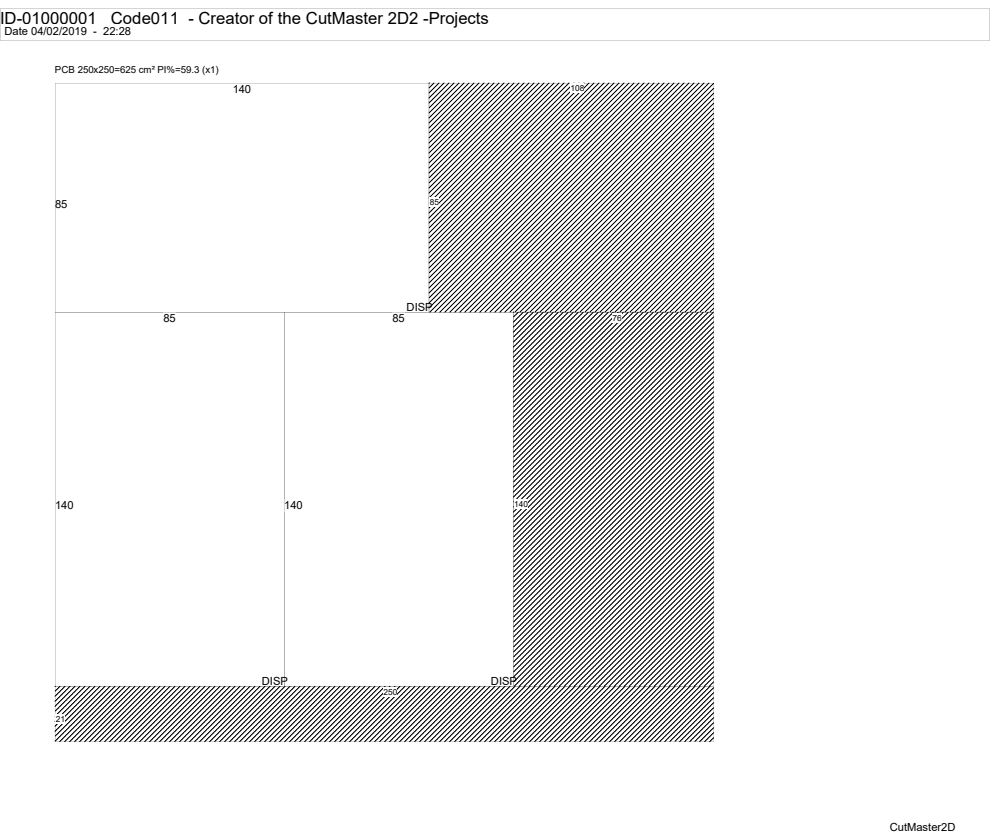
[picture p42: page 2]
DISP; Date 04/02/2019 - 22:28; CutMaster2D

PCB 250x250=625 cm² PI%=59.3 (x1)
