enriquewph/Tablero-de-Crossfit/Proteus/Display 7 segmentos 20x10/TRANSFER A5.pdf

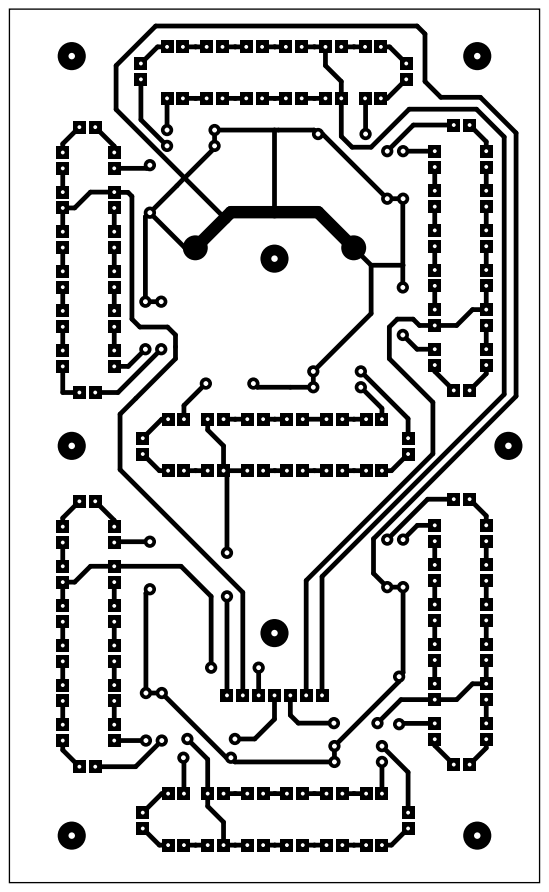
[picture p43: page 1]
