enriquewph/Tablero-de-Crossfit/Proteus/Indicador Segundos/Transfer a5.pdf

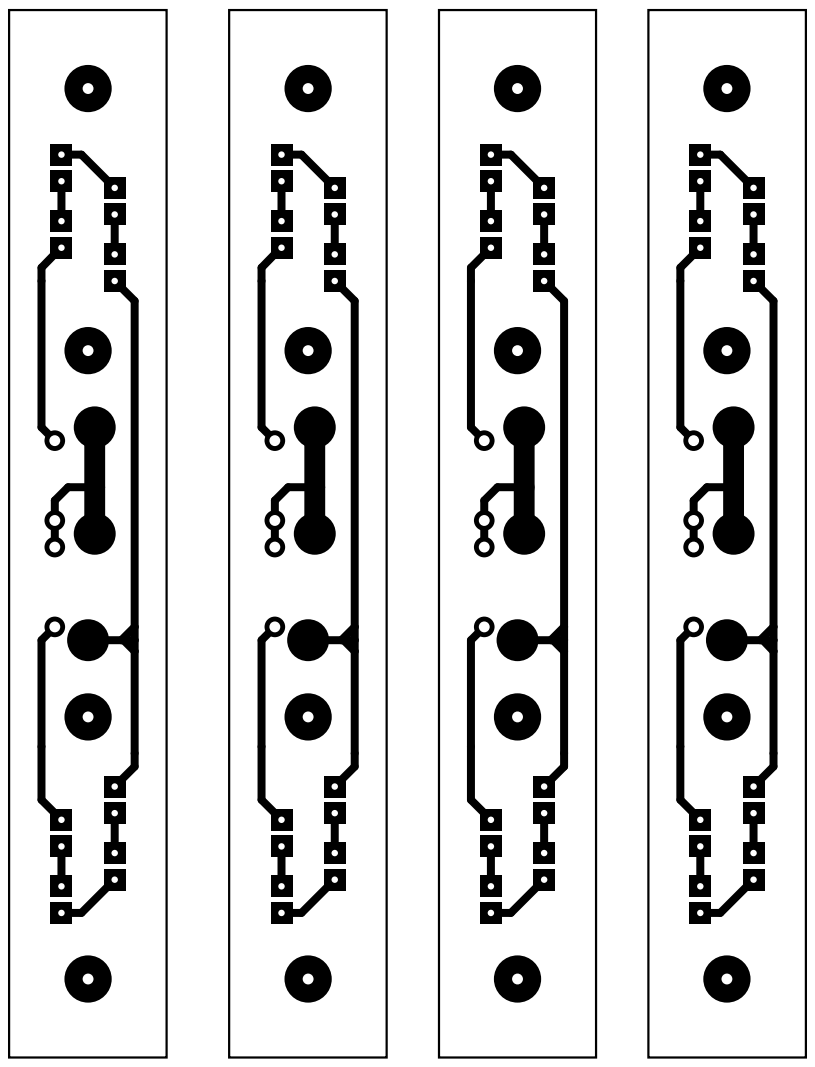
[picture p44: page 1]
