enriquewph/Tablero-de-Crossfit/(list of files, drawings)

Other design files:
Proteus/DHT+IR/Circuito.pdsprj
Proteus/Display 7 segmentos 20x10/Display7seg20x10.pdsprj
Proteus/Indicador Segundos/IndicadorSegundos.pdsprj
Proteus/Modulo Driver Display/74HC595 Modulo.pdsprj
Proteus/Placa de control/Circuito.pdsprj
